hack-rpi/HackRPI-Badge/eagle/HackRPI-Badge.brd

## EAGLE design eagle/HackRPI-Badge.brd (2016-10-06)

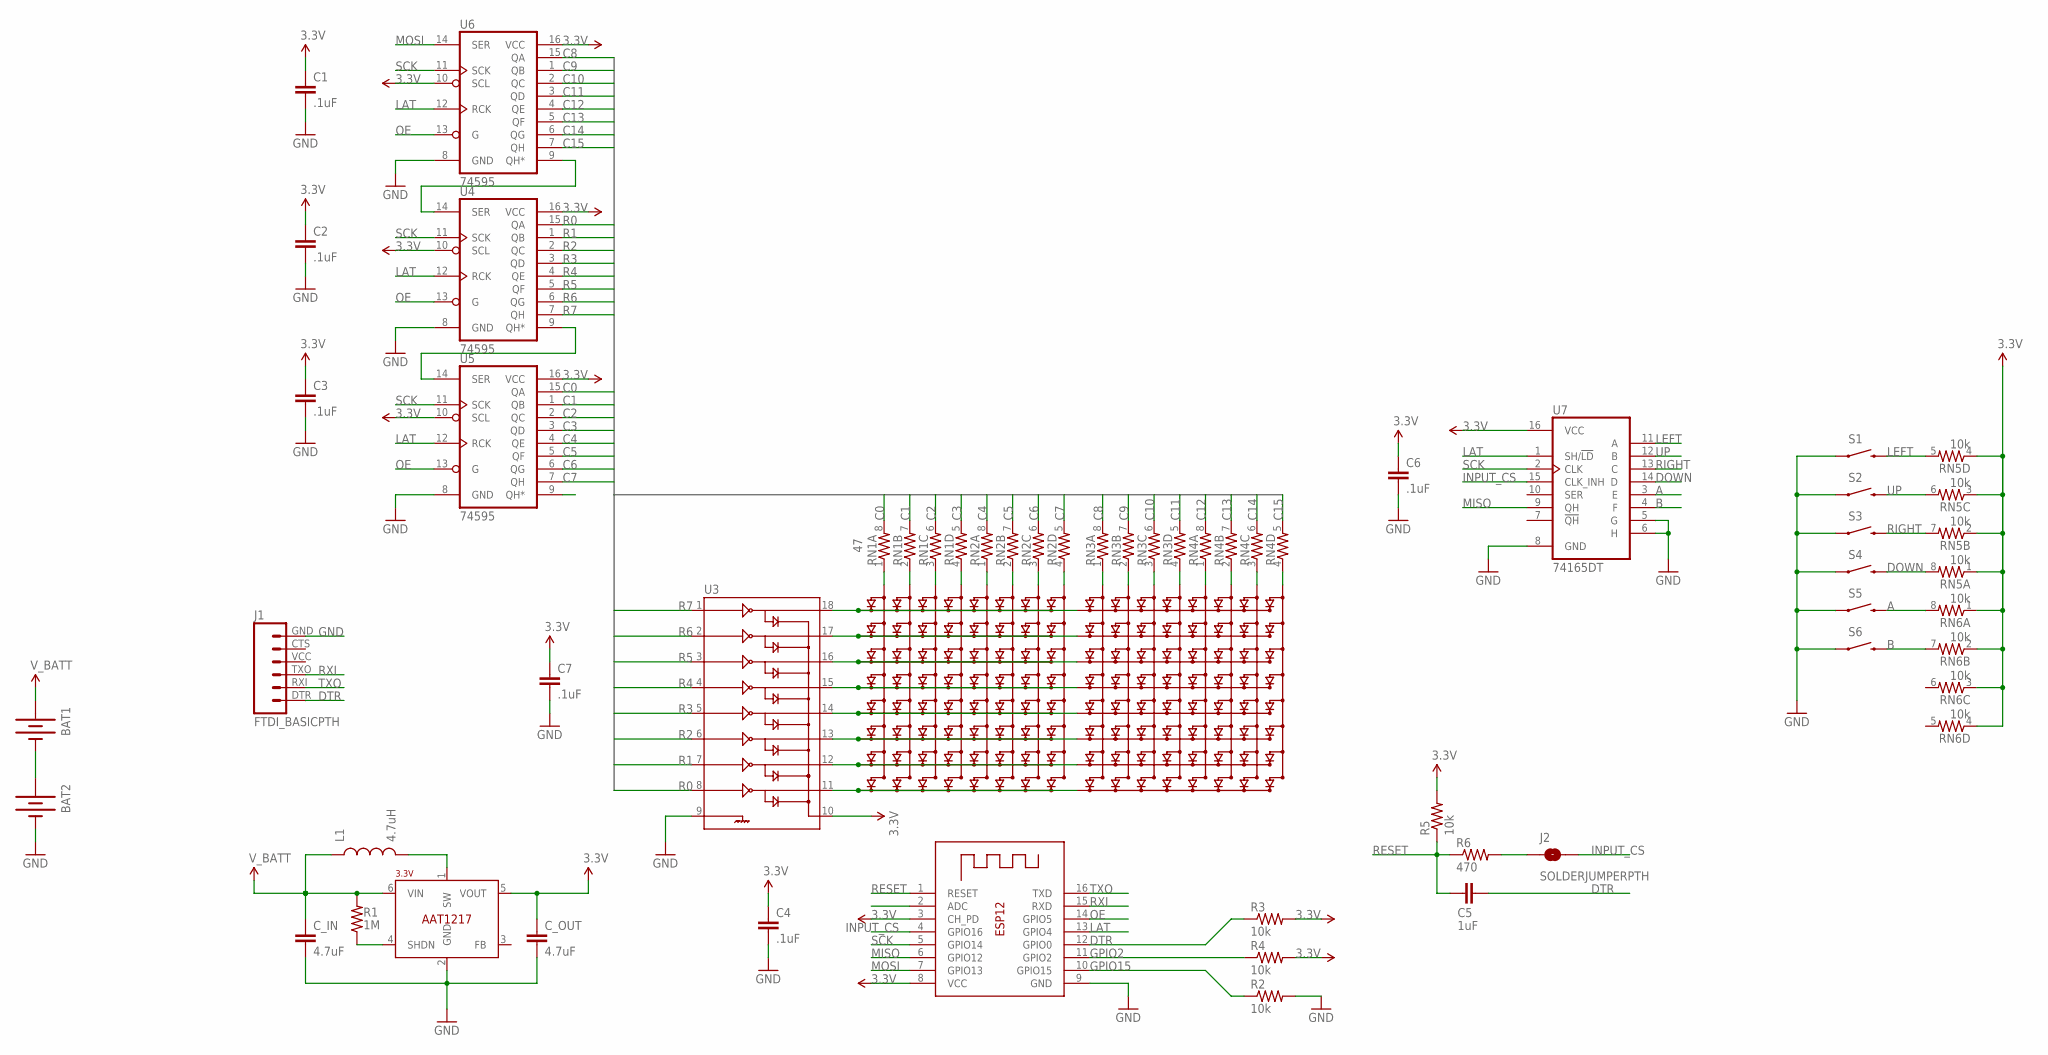
[picture p1: schematic HackRPI-Badge.sch]

Parts:
BAT1, BAT2: BATTERYAAA; BATTERY-AAA; PARTNO BK-82
C1, C2, C3, C4, C6, C7: .1uF; 0603-CAP; PARTNO CC0603ZRY5V9BB104
C5: 1uF; 0603-CAP
C_IN: 4.7uF; 0805; PARTNO CL21A475KQFNNNG
C_OUT: 4.7uF; 0805; PARTNO CL21A475KQFNNNG
J1: FTDI_BASICPTH; FTDI_BASIC
J2: SOLDERJUMPERPTH; SJ_2S-PTH
L1: 4.7uH; 1007; PARTNO CIG22L4R7MNE
LED_LEFT: 8X8LEDMATRIX_COLUMN_CATHODELDM-13488MI; 32MM_LEDMATRIX; PARTNO LDM-13488MI
LED_RIGHT: 8X8LEDMATRIX_COLUMN_CATHODELDM-13488MI; 32MM_LEDMATRIX; PARTNO LDM-13488MI
R1: 1M; 0603-RES; PARTNO RC0603JR-071ML
R2, R3, R4, R5: 10k; 0603-RES; PARTNO RC0603JR-0710KL
R6: 470; 0603-RES; PARTNO RC0603JR-07470RL
RN1, RN2, RN3, RN4: 47; 0603-ARV; PARTNO YC164-JR-0747RL
RN5, RN6: 10k; 0603-ARV; PARTNO 742C083103JP
S1, S2, S3, S4, S5, S6: SWITCH-MOMENTARY-2PTH; TACTILE-PTH; PARTNO 1825910-6
U1: ESP-12; PARTNO 2491
U2: 3.3V; SOT23-6; PARTNO AAT1217ICA-3.3-T1
U3: ULN2803SOICW; SO18L; PARTNO ULN2803AFWG,C,EL
U4, U5, U6: 74595; TSSOP16; PARTNO 74HC595PW,118
U7: 74165DT; TSSOP16; PARTNO MC74HC165ADTR2G

Connections:
3.3V: C1.1, C2.1, C3.1, C4.1, C6.1, C7.1, C_OUT.1, R3.2, R4.2, R5.2, RN5.1, RN5.2 (1), RN5.3 (1), RN5.4 (1), RN6.1, RN6.2 (1), RN6.3 (1), RN6.4 (1), U1.3 (CH_PD), U1.8 (VCC), U2.5 (VOUT), U3.10, U4.10 (SCL), U4.16 (VCC), U5.10 (SCL), U5.16 (VCC), U6.10 (SCL), U6.16 (VCC), U7.16 (VCC)
A: RN6.8 (2), S5.3 (2), U7.3 (E)
B: RN6.7 (2), S6.3 (2), U7.4 (F)
C0: RN1.8 (2), U5.15 (QA)
C1: RN1.7 (2), U5.1 (QB)
C2: RN1.6 (2), U5.2 (QC)
C3: RN1.5 (2), U5.3 (QD)
C4: RN2.8 (2), U5.4 (QE)
C5: RN2.7 (2), U5.5 (QF)
C6: RN2.6 (2), U5.6 (QG)
C7: RN2.5 (2), U5.7 (QH)
C8: RN3.8 (2), U6.15 (QA)
C9: RN3.7 (2), U6.1 (QB)
C10: RN3.6 (2), U6.2 (QC)
C11: RN3.5 (2), U6.3 (QD)
C12: RN4.8 (2), U6.4 (QE)
C13: RN4.7 (2), U6.5 (QF)
C14: RN4.6 (2), U6.6 (QG)
C15: RN4.5 (2), U6.7 (QH)
DOWN: RN5.8 (2), S4.3 (2), U7.14 (D)
DTR: C5.2, J1.DTR (1), R3.1, U1.12 (GPIO0)
GND: BAT2.GND@1 (-), C1.2, C2.2, C3.2, C4.2, C6.2, C7.2, C_IN.2, C_OUT.2, J1.GND (6), R2.2, S1.1, S2.1, S3.1, S4.1, S5.1, S6.1, U1.9 (GND), U2.2 (GND), U3.9, U4.8 (GND), U5.8 (GND), U6.8 (GND), U7.5 (G), U7.6 (H), U7.8 (GND)
GPIO2: R4.1, U1.11 (GPIO2)
GPIO15: R2.1, U1.10 (GPIO15)
INPUT_CS: J2.2, U1.4 (GPIO16), U7.15 (CLK_INH)
LAT: U1.13 (GPIO4), U4.12 (RCK), U5.12 (RCK), U6.12 (RCK), U7.1 (SH/!LD)
LEFT: RN5.5 (2), S1.3 (2), U7.11 (A)
MISO: U1.6 (GPIO12), U7.9 (QH)
MOSI: U1.7 (GPIO13), U6.14 (SER)
unnamed: J2.1, R6.2
unnamed: LED_LEFT.13 (C1), RN1.1
unnamed: LED_LEFT.3 (C2), RN1.2 (1)
unnamed: L1.2, U2.1 (SW)
unnamed: R1.1, U2.4 (SHDN)
unnamed: LED_LEFT.9 (R1), LED_RIGHT.9 (R1), U3.18
unnamed: LED_LEFT.4 (C3), RN1.3 (1)
unnamed: LED_LEFT.10 (C4), RN1.4 (1)
unnamed: LED_LEFT.6 (C5), RN2.1
unnamed: LED_LEFT.11 (C6), RN2.2 (1)
unnamed: LED_LEFT.15 (C7), RN2.3 (1)
unnamed: LED_LEFT.16 (C8), RN2.4 (1)
unnamed: LED_LEFT.14 (R2), LED_RIGHT.14 (R2), U3.17
unnamed: LED_LEFT.8 (R3), LED_RIGHT.8 (R3), U3.16
unnamed: LED_LEFT.12 (R4), LED_RIGHT.12 (R4), U3.15
unnamed: LED_LEFT.1 (R5), LED_RIGHT.1 (R5), U3.14
unnamed: LED_LEFT.7 (R6), LED_RIGHT.7 (R6), U3.13
unnamed: LED_LEFT.2 (R7), LED_RIGHT.2 (R7), U3.12
unnamed: LED_LEFT.5 (R8), LED_RIGHT.5 (R8), U3.11
unnamed: U4.9 (QH*), U5.14 (SER)
unnamed: U4.14 (SER), U6.9 (QH*)
unnamed: LED_RIGHT.13 (C1), RN3.1
unnamed: LED_RIGHT.3 (C2), RN3.2 (1)
unnamed: LED_RIGHT.4 (C3), RN3.3 (1)
unnamed: LED_RIGHT.10 (C4), RN3.4 (1)
unnamed: LED_RIGHT.6 (C5), RN4.1
unnamed: LED_RIGHT.11 (C6), RN4.2 (1)
unnamed: LED_RIGHT.15 (C7), RN4.3 (1)
unnamed: LED_RIGHT.16 (C8), RN4.4 (1)
unnamed: BAT1.GND@1 (-), BAT2.PWR@1 (+)
OE: U1.14 (GPIO5), U4.13 (G), U5.13 (G), U6.13 (G)
R0: U3.8, U4.15 (QA)
R1: U3.7, U4.1 (QB)
R2: U3.6, U4.2 (QC)
R3: U3.5, U4.3 (QD)
R4: U3.4, U4.4 (QE)
R5: U3.3, U4.5 (QF)
R6: U3.2, U4.6 (QG)
R7: U3.1, U4.7 (QH)
RESET: C5.1, R5.1, R6.1, U1.1 (RESET)
RIGHT: RN5.7 (2), S3.3 (2), U7.13 (C)
RXI: J1.TXO (3), U1.15 (RXD)
SCK: U1.5 (GPIO14), U4.11 (SCK), U5.11 (SCK), U6.11 (SCK), U7.2 (CLK)
TXO: J1.RXI (2), U1.16 (TXD)
UP: RN5.6 (2), S2.3 (2), U7.12 (B)
V_BATT: BAT1.PWR@1 (+), C_IN.1, L1.1, R1.2, U2.6 (VIN)

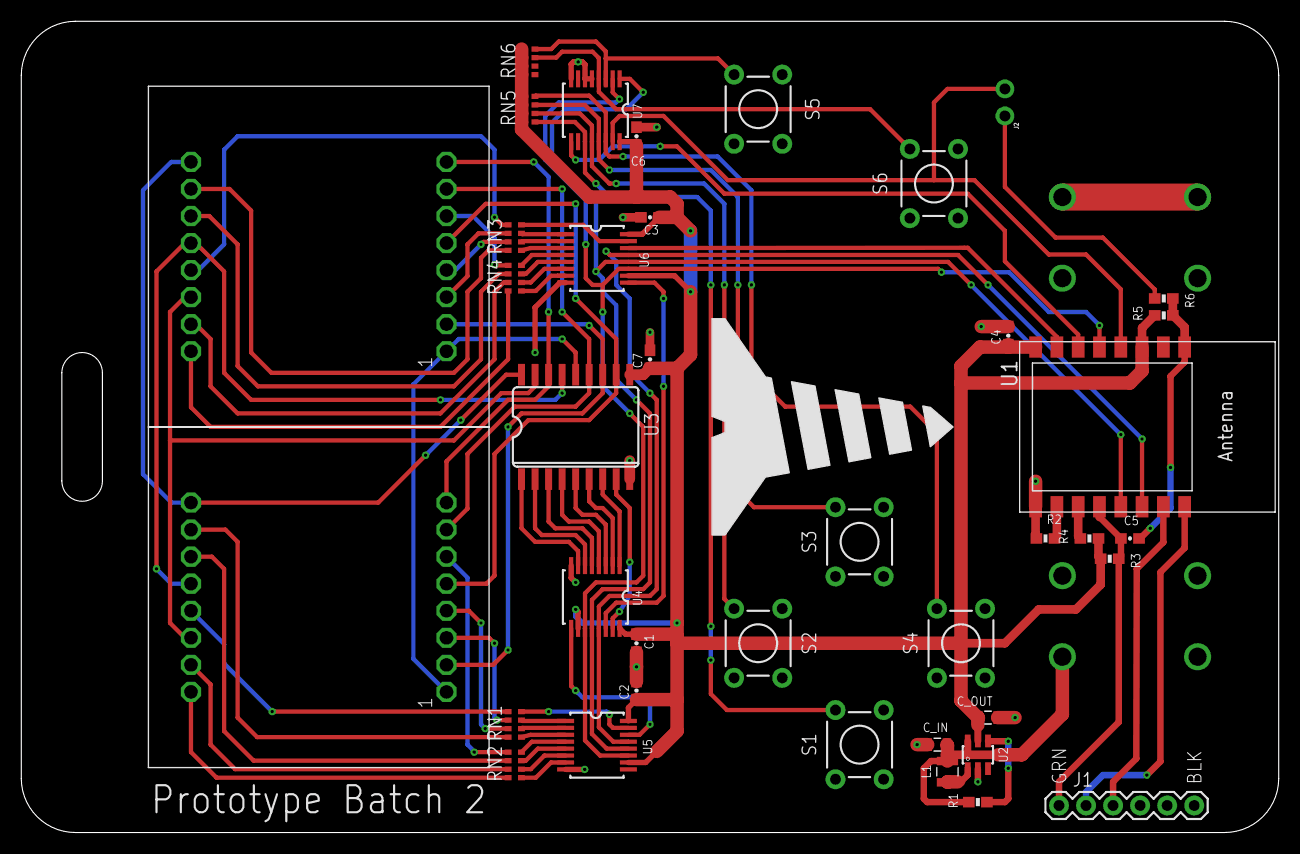
[picture p2: board HackRPI-Badge.brd from above]

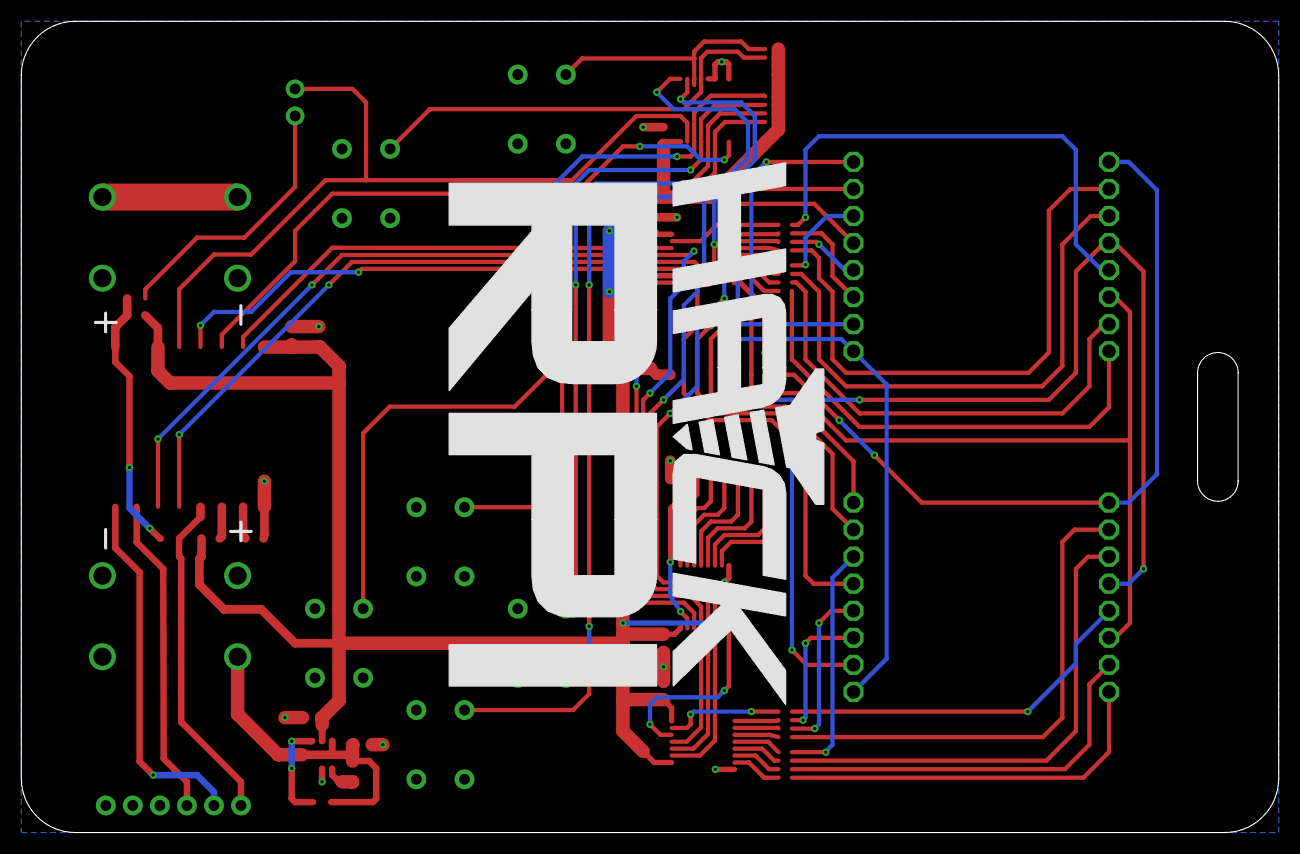
[picture p3: board HackRPI-Badge.brd from below]

Board: 2 copper layers, 118.1 x 76.2 mm, 43 parts (3 on the bottom side), 75 nets.

Other parts of the board:
U$1: HACKRPI-LOGO
U$2: HACKRPI-SCREW
