hack-rpi/HackRPI-Badge/src/HackBadgeLib/typeset.c

// size_t
#include <stddef.h>
// uint8_t
#include <stdint.h>

/// The first character represented in the typeset.
const char TYPESET_FIRST_CHAR = ' ';
/// The last character represented in the typeset.
const char TYPESET_LAST_CHAR  = '~';
/// A list of column offsets per character.
const size_t TYPESET_OFFSETS[] = 
{
	0,   /*   */
	2,   /* ! */
	3,   /* " */
	6,   /* # */
	13,  /* $ */
	18,  /* % */
	25,  /* & */
	31,  /* ' */
	32,  /* ( */
	35,  /* ) */
	38,  /* * */
	43,  /* + */
	48,  /* , */
	50,  /* - */
	55,  /* . */
	57,  /* / */
	60,  /* 0 */
	65,  /* 1 */
	70,  /* 2 */
	75,  /* 3 */
	80,  /* 4 */
	85,  /* 5 */
	90,  /* 6 */
	95,  /* 7 */
	100, /* 8 */
	105, /* 9 */
	110, /* : */
	112, /* ; */
	114, /* < */
	118, /* = */
	122, /* > */
	126, /* ? */
	131, /* @ */
	137, /* A */
	142, /* B */
	146, /* C */
	150, /* D */
	154, /* E */
	158, /* F */
	162, /* G */
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
	370, /*end*/
};

/// An 8 pixel tall bitmap of the typeset. Every byte is a column in the bitmap.
const uint8_t TYPESET_BITMAP[] = {
	0x00,
	0x00,
	0xbf,
	0x03,
	0x00,
	0x03,
	0x20,
	0xe4,
	0x3c,
	0xe7,
	0x3c,
	0x27,
	0x04,
	0x44,
	0x4a,
	0xff,
	0x52,
	0x22,
	0x02,
	0xc5,
	0x22,
	0x18,
	0x44,
	0xa3,
	0x40,
	0x76,
	0x89,
	0x99,
	0x66,
	0xa0,
	0x10,
	0x06,
	0x3c,
	0x42,
	0x81,
	0x81,
	0x42,
	0x3c,
	0x0a,
	0x04,
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
};
