hack-rpi/HackRPI-Badge/(commit log)

2016-08-25 Moved resistor nets to ensure constant LED brightness, added serial connector, added 74HC165 for input
    [HackRPI-Badge.brd, HackRPI-Badge.sch]
2016-08-31 Updated part names, misc work
    [HackRPI-Badge.brd, HackRPI-Badge.sch]
2016-09-01 Placed components on board, routed LED matrices and output shift registers, rounded corners of board
    [HackRPI-Badge.brd, HackRPI-Badge.sch]
2016-09-06 Finished laying out/routing first revision of board
    [HackRPI-Badge.brd, HackRPI-Badge.sch]
2016-09-12 Added flash memory for storing certificates, named some nets to be more clear
    [HackRPI-Badge.brd, HackRPI-Badge.sch]
2016-09-12 Fixed 74165 sck pin connection, updated gitignore to ignore lock files
    [HackRPI-Badge.brd, HackRPI-Badge.sch]
2016-09-12 Generated gerbers for board
    [HackRPI-Badge.GBL, HackRPI-Badge.GBO, HackRPI-Badge.GBS, HackRPI-Badge.GTL, HackRPI-Badge.GTO, HackRPI-Badge.GTP, HackRPI-Badge.GTS]
2016-09-12 Added prototype batch designation to board and regenerated gerbers
    [HackRPI-Badge.brd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]
2016-09-16 Added bom partno attributes to all parts
    [HackRPI-Badge.brd]
2016-09-16 Fixed bom part numbers
    [HackRPI-Badge.sch]
2016-09-23 Moved all eagle files to an eagle folder
    [HackRPI-Badge.brd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]
2016-09-23 Fixed AAT1217 pinout and modified board for correct pinout
    [HackRPI-Badge.brd, HackRPI-Badge.sch]
2016-09-24 Fixed ESP12 pinout
    [HackRPI-Badge.brd, HackRPI-Badge.sch]
2016-09-24 Implemented LED display control in badge library, added demo code
2016-09-25 Fixed writeText function, added missing ']' character in typeset, added function to measure text width, updated demo code
    [HackBadge.cpp, HackBadge.hpp, HackBadgeLib.ino, typeset.c]
2016-09-26 Fixed OTA updating in demo code
    [HackBadgeLib.ino]
2016-09-27 Fixed layout to use correct esp8266 pinout
    [HackRPI-Badge.brd]
2016-09-27 Tented vias, added HackRPI logo on back of board
    [HackRPI-Badge.brd]
2016-09-27 Added HackRPI screw on front of board, removed temporary HackRPI text
    [HackRPI-Badge.brd]
2016-09-27 Changed board batch text to batch 2
    [HackRPI-Badge.brd]
2016-09-27 Removed external flash memory from badge (ESP-12 module has plenty of flash onboard)
    [HackRPI-Badge.brd, HackRPI-Badge.sch]
2016-09-29 Moved batteries away from eachother
    [HackRPI-Badge.brd]
2016-09-29 Moved buttons, changed some pin assignments, added input shift register source
    [HackRPI-Badge.brd, HackRPI-Badge.sch]
2016-09-30 Got button input working (needs code cleanup)
2016-10-04 Tied GPIO0 to DTR, changed deep sleep jumper to normally open (necessary for programming)
    [HackRPI-Badge.brd, HackRPI-Badge.sch]
2016-10-05 Moved ESP module to center-bottom of badge and made the badge smaller, re-routed traces after resizing badge
    [HackRPI-Badge.brd, HackRPI-Badge.sch]
2016-10-05 Updated logo and screw on board to have width (prevents errors during gerber generation), regenerated gerbers
    [HackRPI-Badge.brd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]
2016-10-06 Fixed badge corner not being flush with edge
    [HackRPI-Badge.brd]
2016-10-06 Regenerated gerbers
    [HackRPI-Badge.GBL, HackRPI-Badge.GTL]
2016-10-06 Another corner fix
    [HackRPI-Badge.brd]
2016-10-06 Fixed LED matrix name typo, updated BOM info for a capacitor
    [HackRPI-Badge.brd, HackRPI-Badge.sch]
